Hamza-Anver/OmniStimDriverBoard-PCB/README.md

# OmniStim Eval Board

This is an evaluation board to test operating principles of the OptiStim head unit. 

Fabricated with JLCPCB in April 2025, designed with KiCAD.

It is designed to use the ESP32 Audio PLL to create a signal between approximately 5MHz to 80MHz. This signal is then conditioned and used to drive an LC tank, where the capacitance can be varied digitally and by the DIP switches.

Future designs will have their capacitance entirely digitally controlled, and be miniaturized.

This board is intended only to test if the ESP32 with this conditioning can successfully drive the LC tank and if the resonance of the tank can be subsequently measured by the ESP32. 

# ChangeLog
## Revision 2 DriverBoard
[x] - switched varicaps from LXRW19V330-050 to LXRW0YV600-054, for JLC availability
[x] - have signal reed relays for coarse capacitance switching

## Revision 2 EvalBoard
[x] - USB to Serial RX TX swapped
[x] - Added RXT and TXT LEDs for serial status
[x] - Typo JTAG connector (TDI instead of 3V3)
[x] - Missing EN and IO0 on UART breakout added
[x] - Added USB C connector using ESP32 USB OTG pins (also changed ADC pin on ESP32)
[ ] - added a lot more testpoints

## Revision 1 EvalBoard
[GitHub Commit ID: ace2972b83d641ddb22a6ab950a8797fcb3666a8](https://github.com/Hamza-Anver/OmniStimEvalBoard-Hardware/tree/ace2972b83d641ddb22a6ab950a8797fcb3666a8)
Was revision 1
