Hamza-Anver/OmniStimDriverBoard-PCB/plots/OptoGeneticHeadStage__Assembly.pdf

1 | 2 | 3 | 4 | 5 | 6

A

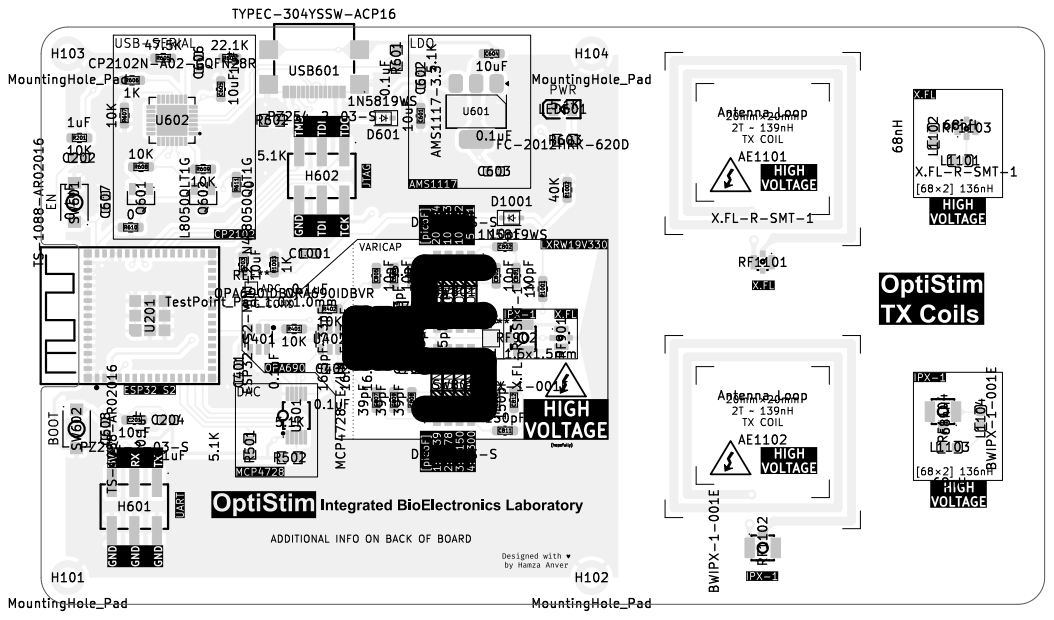
[picture p1: page 1]

ADDITIONAL INFO ON BACK OF BOARD

1 | 2 | 3 | 4 | 5 | 6

A

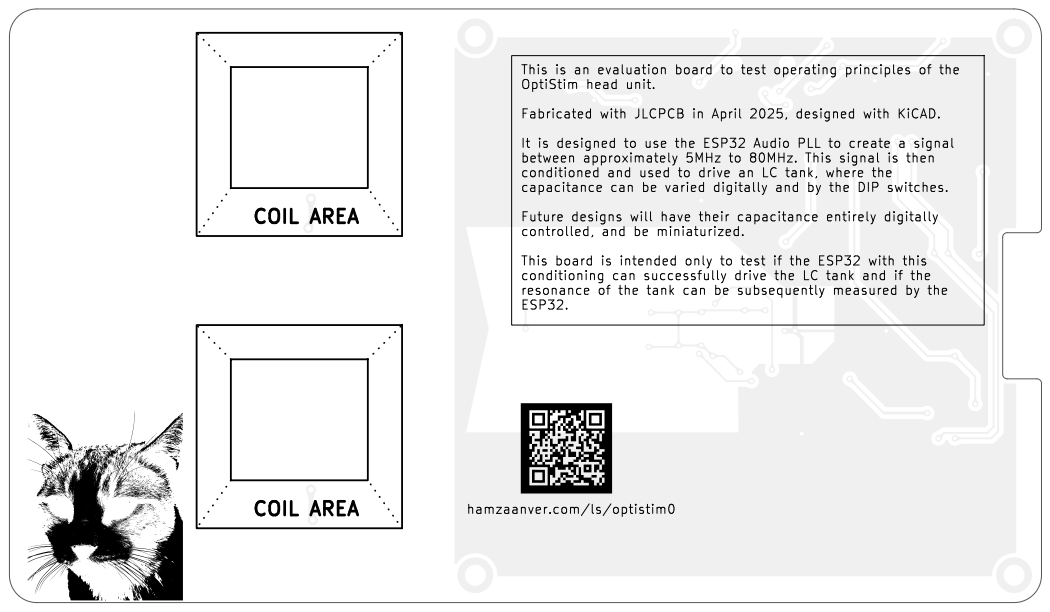
[picture p2: page 2]
COIL; AREA; hamzaanver.com/ls/optistim0 This is an evaluation; board to test operating; principles; of the OptiStim head unit. Fabricated; with JLCPCB in April 2025, designed with KiCAD.; It is designed to use the ESP32 Audio PLL to create; signal between approximately; 5MHz to 80MHz.; This signal is; then; conditioned; and used to drive an LC tank, where the; capacitance; can be varied digitally; and; by the; DIP switches. Future designs will have their capacitance; entirely digitally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
