Hamza-Anver/OmniStimDriverBoard-PCB/OmniStimDriverBoard-PCB.kicad_sch

## KiCad design OmniStimDriverBoard-PCB.kicad_sch (2025-04-27)

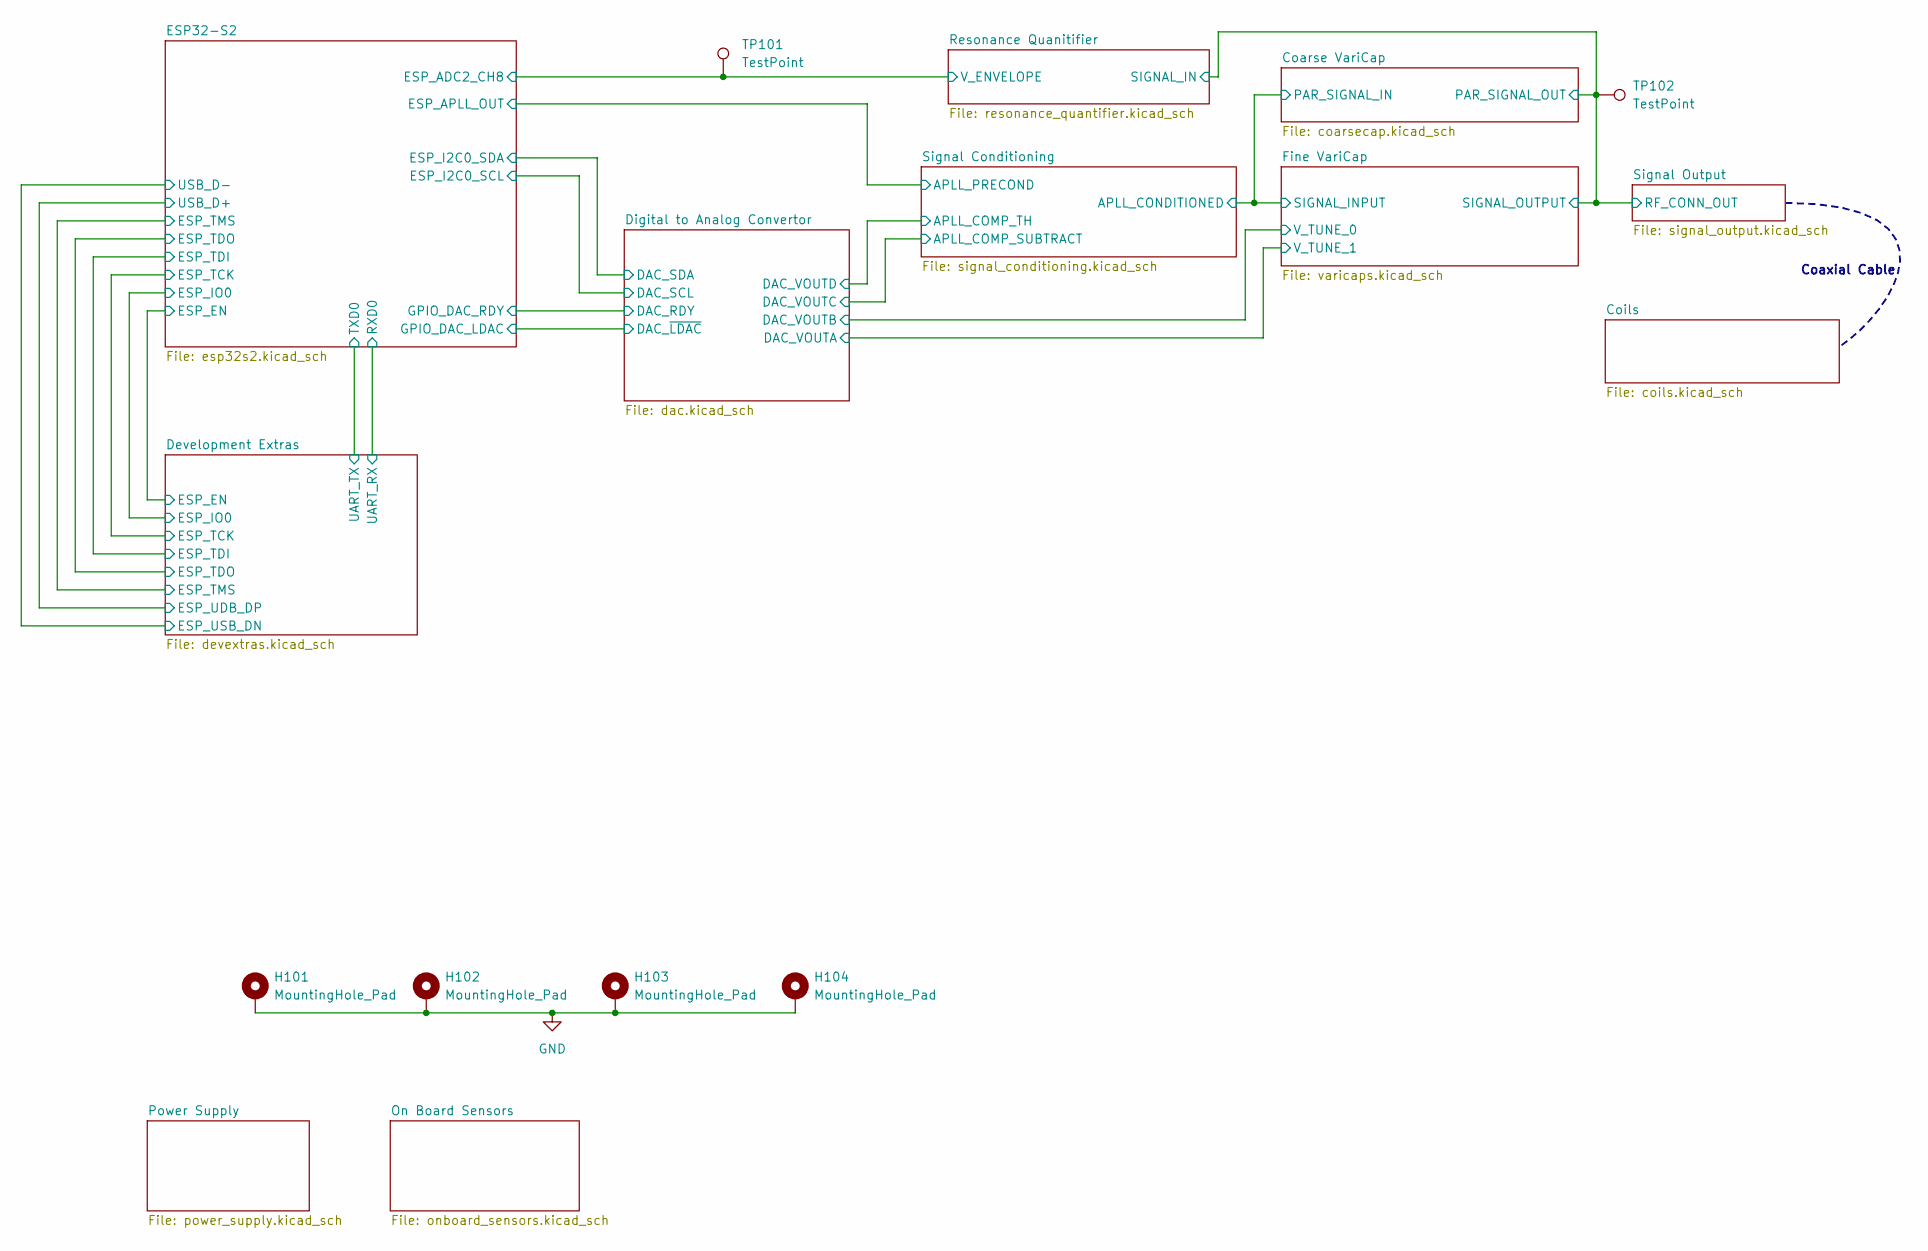
[picture p3: schematic OmniStimDriverBoard-PCB.kicad_sch]

Parts:
H101, H102, H103, H104: MountingHole_Pad; MountingHole_2.2mm_M2_ISO14580_Pad_TopBottom
TP101, TP102: TestPoint; TestPoint_Pad_1.0x1.0mm

Connections:
GND: H101.1, H102.1, H103.1, H104.1
SIGNAL_IN: TP102.1
V_ENVELOPE: TP101.1

Notes on the sheet:
Coaxial Cable
