Hamza-Anver/OmniStimDriverBoard-PCB/coarsecap.kicad_sch

## KiCad design coarsecap.kicad_sch (2025-04-27)

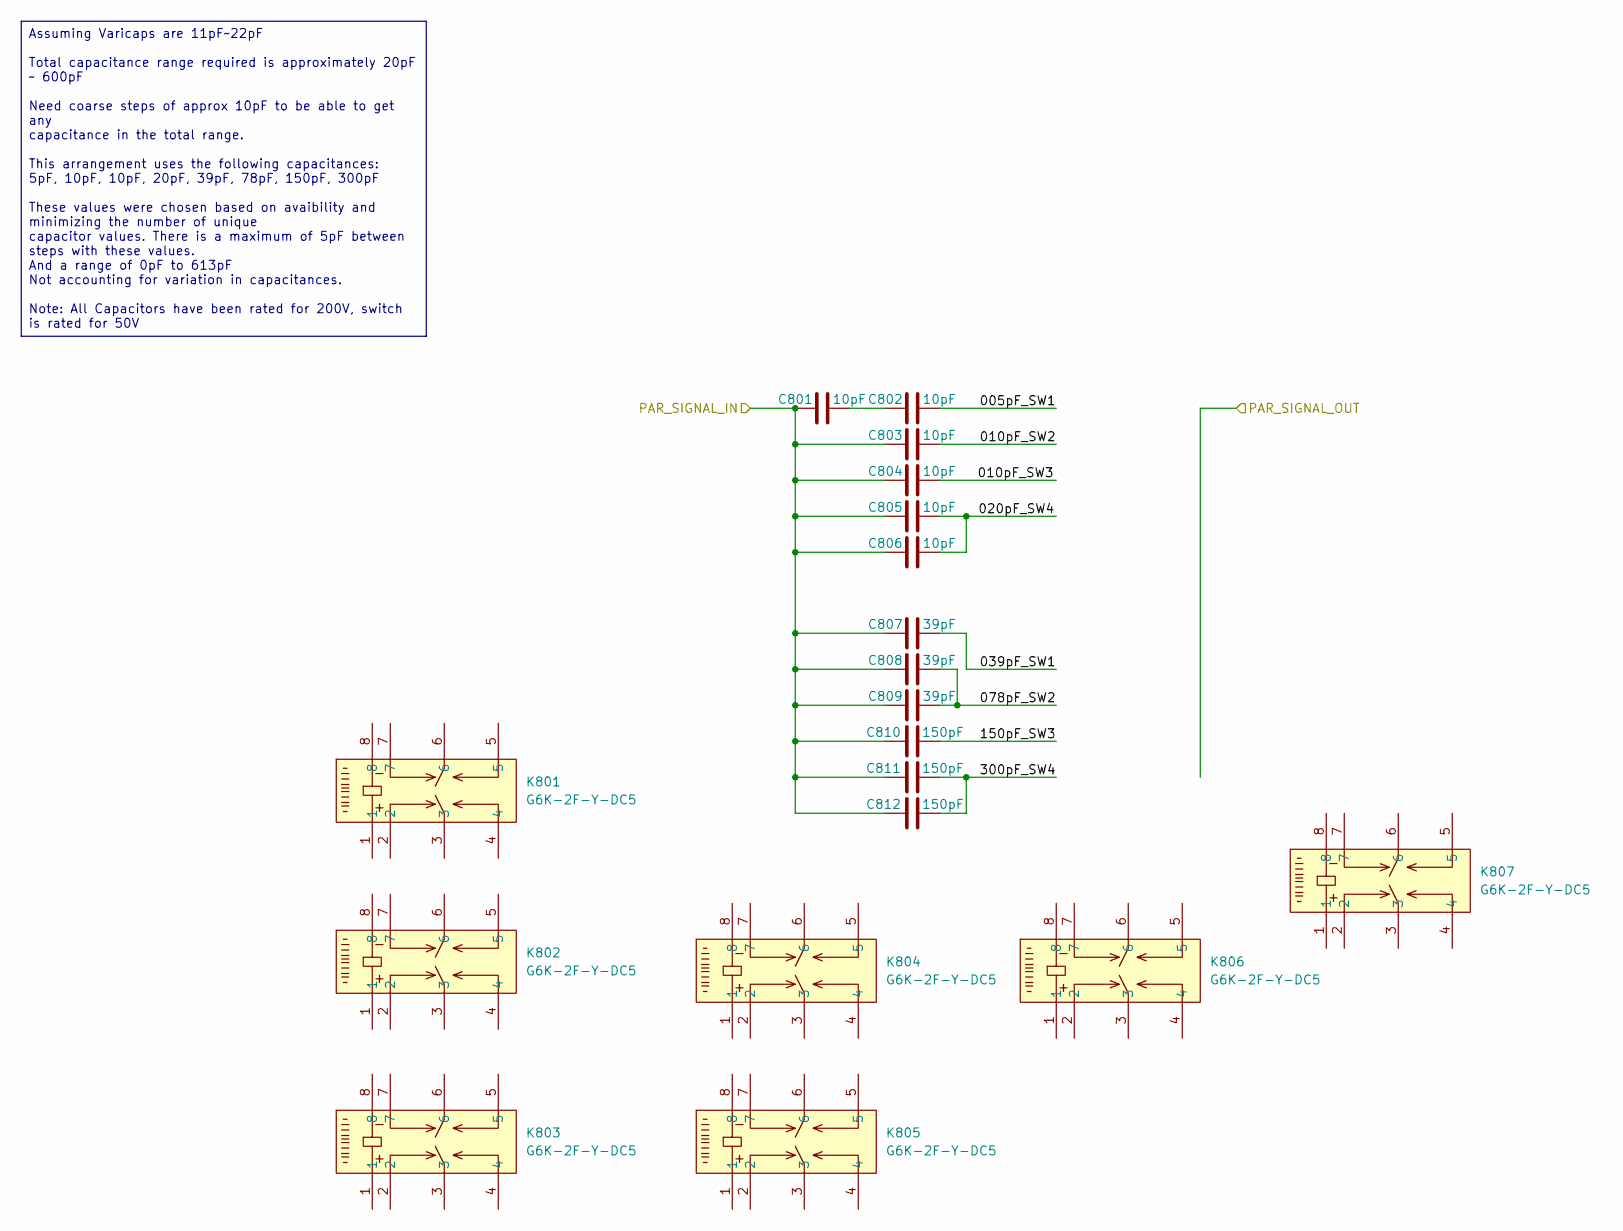
[picture p4: schematic coarsecap.kicad_sch]

Parts:
C801, C802, C803, C804, C805, C806: 10pF; C_0603_1608Metric_Pad1.08x0.95mm_HandSolder; MPN 0603CG100J201NT; LCSC C63673
C807, C808, C809: 39pF; C_0603_1608Metric_Pad1.08x0.95mm_HandSolder; MPN 0603CG390J201NT; LCSC C63687
C810, C811, C812: 150pF; C_0603_1608Metric_Pad1.08x0.95mm_HandSolder; MPN 0603CG151J201NT; LCSC C63701
K801, K802, K803, K804, K805, K806, K807: G6K-2F-Y-DC5; RELAY-SMD_G6K-2F-X-XX; LCSC Part C47190

Connections:
005pF_SW1: C802.2
010pF_SW2: C803.2
010pF_SW3: C804.2
020pF_SW4: C805.2, C806.2
039pF_SW1: C807.2
078pF_SW2: C808.2, C809.2
150pF_SW3: C810.2
300pF_SW4: C811.2, C812.2
unnamed: C801.2, C802.1
PAR_SIGNAL_IN: C801.1, C803.1, C804.1, C805.1, C806.1, C807.1, C808.1, C809.1, C810.1, C811.1, C812.1

Notes on the sheet:
Assuming Varicaps are 11pF~22pF Total capacitance range required is approximately 20pF ~ 600pF Need coarse steps of approx 10pF to be able to get any capacitance in the total range. This arrangement uses the following capacitances: 5pF, 10pF, 10pF, 20pF, 39pF, 78pF, 150pF, 300pF These values were c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
