Hamza-Anver/OmniStimDriverBoard-PCB/coils.kicad_sch

## KiCad design coils.kicad_sch (2025-04-14)

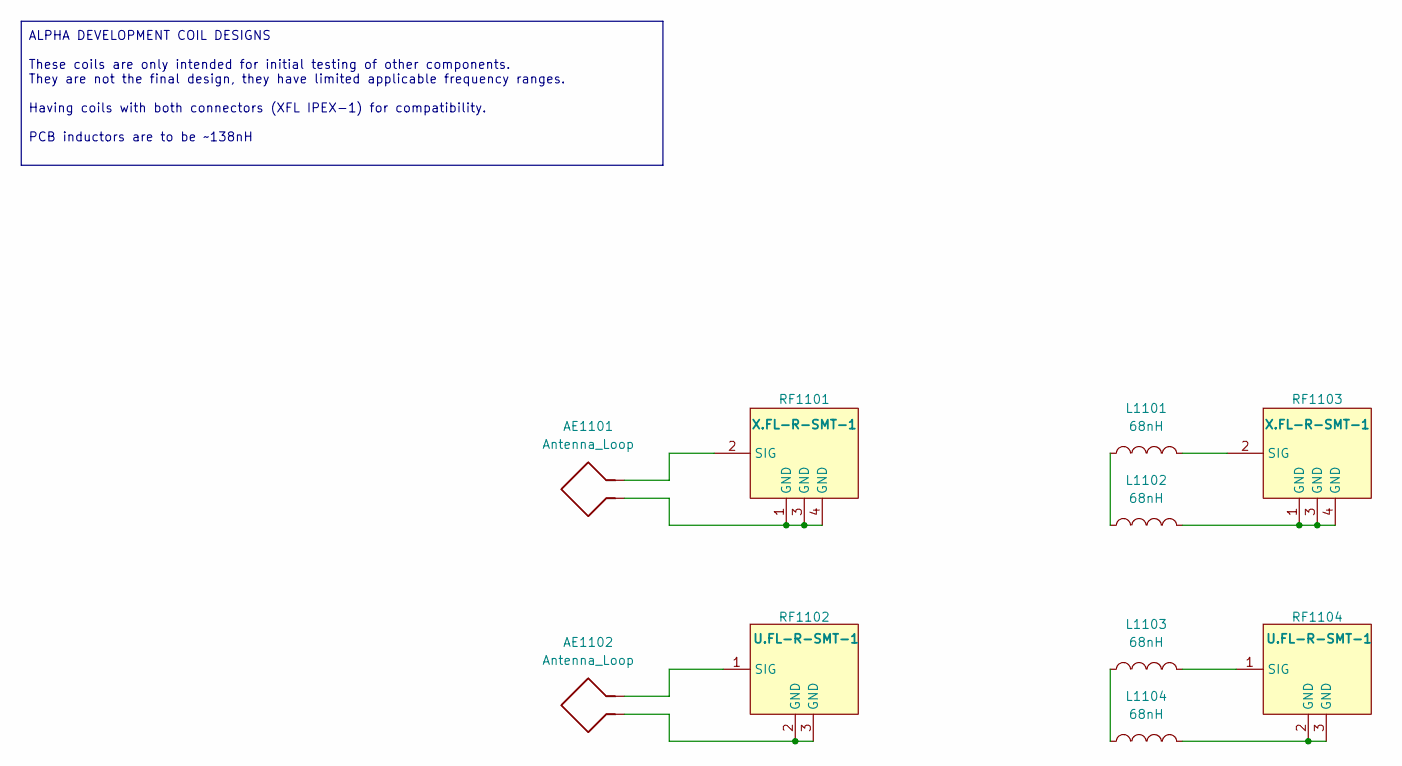
[picture p5: schematic coils.kicad_sch]

Parts:
AE1101, AE1102: Antenna_Loop; Tx_20x20_2t
L1101, L1102, L1103, L1104: 68nH; L0603; MPN LQG18HN68NJ00D; LCSC Part C162555
RF1101, RF1103: X.FL-R-SMT-1; ANT-SMD_XFL-R-SMT-1; MPN X.FL-R-SMT-1(80); LCSC Part C434819
RF1102, RF1104: U.FL-R-SMT-1; RF-SMD_FRF05002-JSS103M; LCSC Part C88374

Connections:
unnamed: AE1101.1, RF1101.1 (GND), RF1101.3 (GND), RF1101.4 (GND)
unnamed: AE1101.2, RF1101.2 (SIG)
unnamed: AE1102.1, RF1102.2 (GND), RF1102.3 (GND)
unnamed: AE1102.2, RF1102.1 (SIG)
unnamed: L1101.1, RF1103.2 (SIG)
unnamed: L1101.2, L1102.2
unnamed: L1102.1, RF1103.1 (GND), RF1103.3 (GND), RF1103.4 (GND)
unnamed: L1103.1, RF1104.1 (SIG)
unnamed: L1103.2, L1104.2
unnamed: L1104.1, RF1104.2 (GND), RF1104.3 (GND)

Notes on the sheet:
ALPHA DEVELOPMENT COIL DESIGNS These coils are only intended for initial testing of other components. They are not the final design, they have limited applicable frequency ranges. Having coils with both connectors (XFL IPEX-1) for compatibility. PCB inductors are to be ~138nH
