Hamza-Anver/OmniStimDriverBoard-PCB/dac.kicad_sch

## KiCad design dac.kicad_sch (2025-04-14)

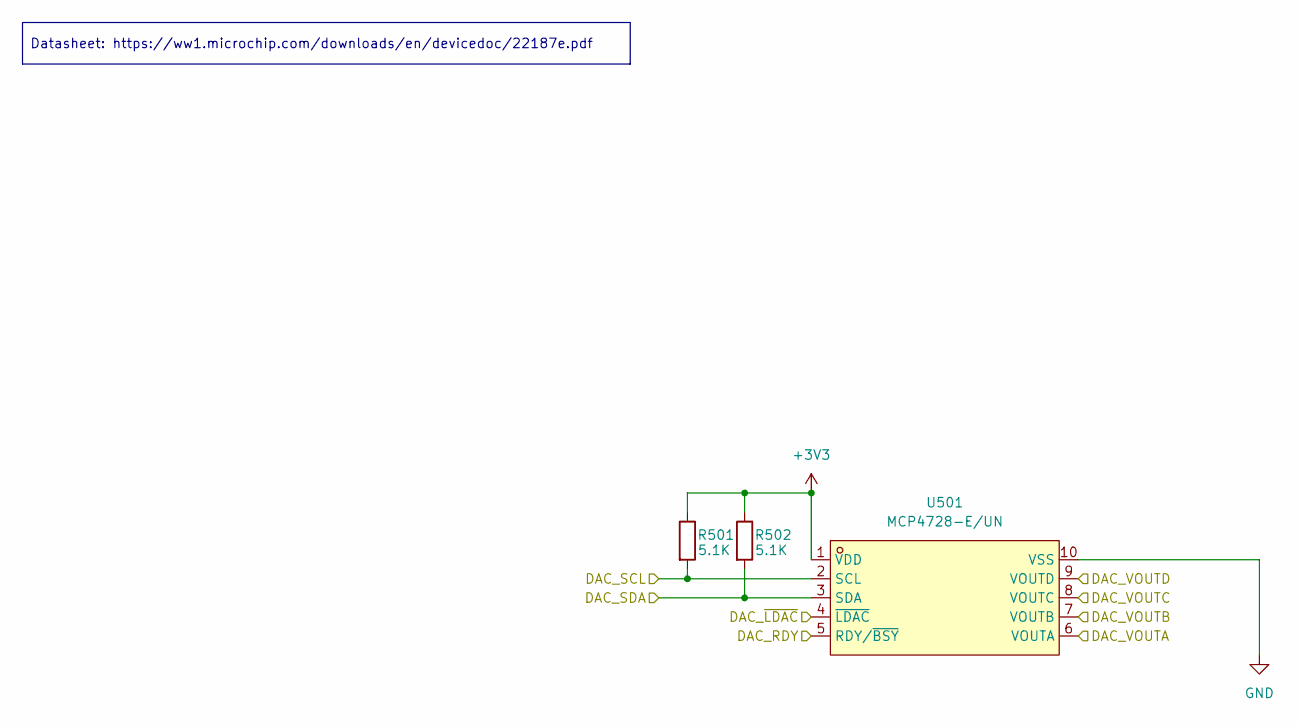
[picture p6: schematic dac.kicad_sch]

Parts:
R501, R502: 5.1K; R0603; MPN RC0603FR-075K1L; LCSC Part C105580
U501: MCP4728-E/UN; MSOP-10_L3.0-W3.0-P0.50-LS5.0-TL; LCSC Part C108207

Connections:
+3V3: R501.2, R502.2, U501.1 (VDD)
DAC_RDY: U501.5 (RDY/~BSY)
DAC_SCL: R501.1, U501.2 (SCL)
DAC_SDA: R502.1, U501.3 (SDA)
DAC_VOUTA: U501.6 (VOUTA)
DAC_VOUTB: U501.7 (VOUTB)
DAC_VOUTC: U501.8 (VOUTC)
DAC_VOUTD: U501.9 (VOUTD)
DAC_~LDAC: U501.4 (~LDAC)
GND: U501.10 (VSS)

Notes on the sheet:
Datasheet: https://ww1.microchip.com/downloads/en/devicedoc/22187e.pdf
