Hamza-Anver/OmniStimDriverBoard-PCB/devextras.kicad_sch

## KiCad design devextras.kicad_sch (2025-04-23)

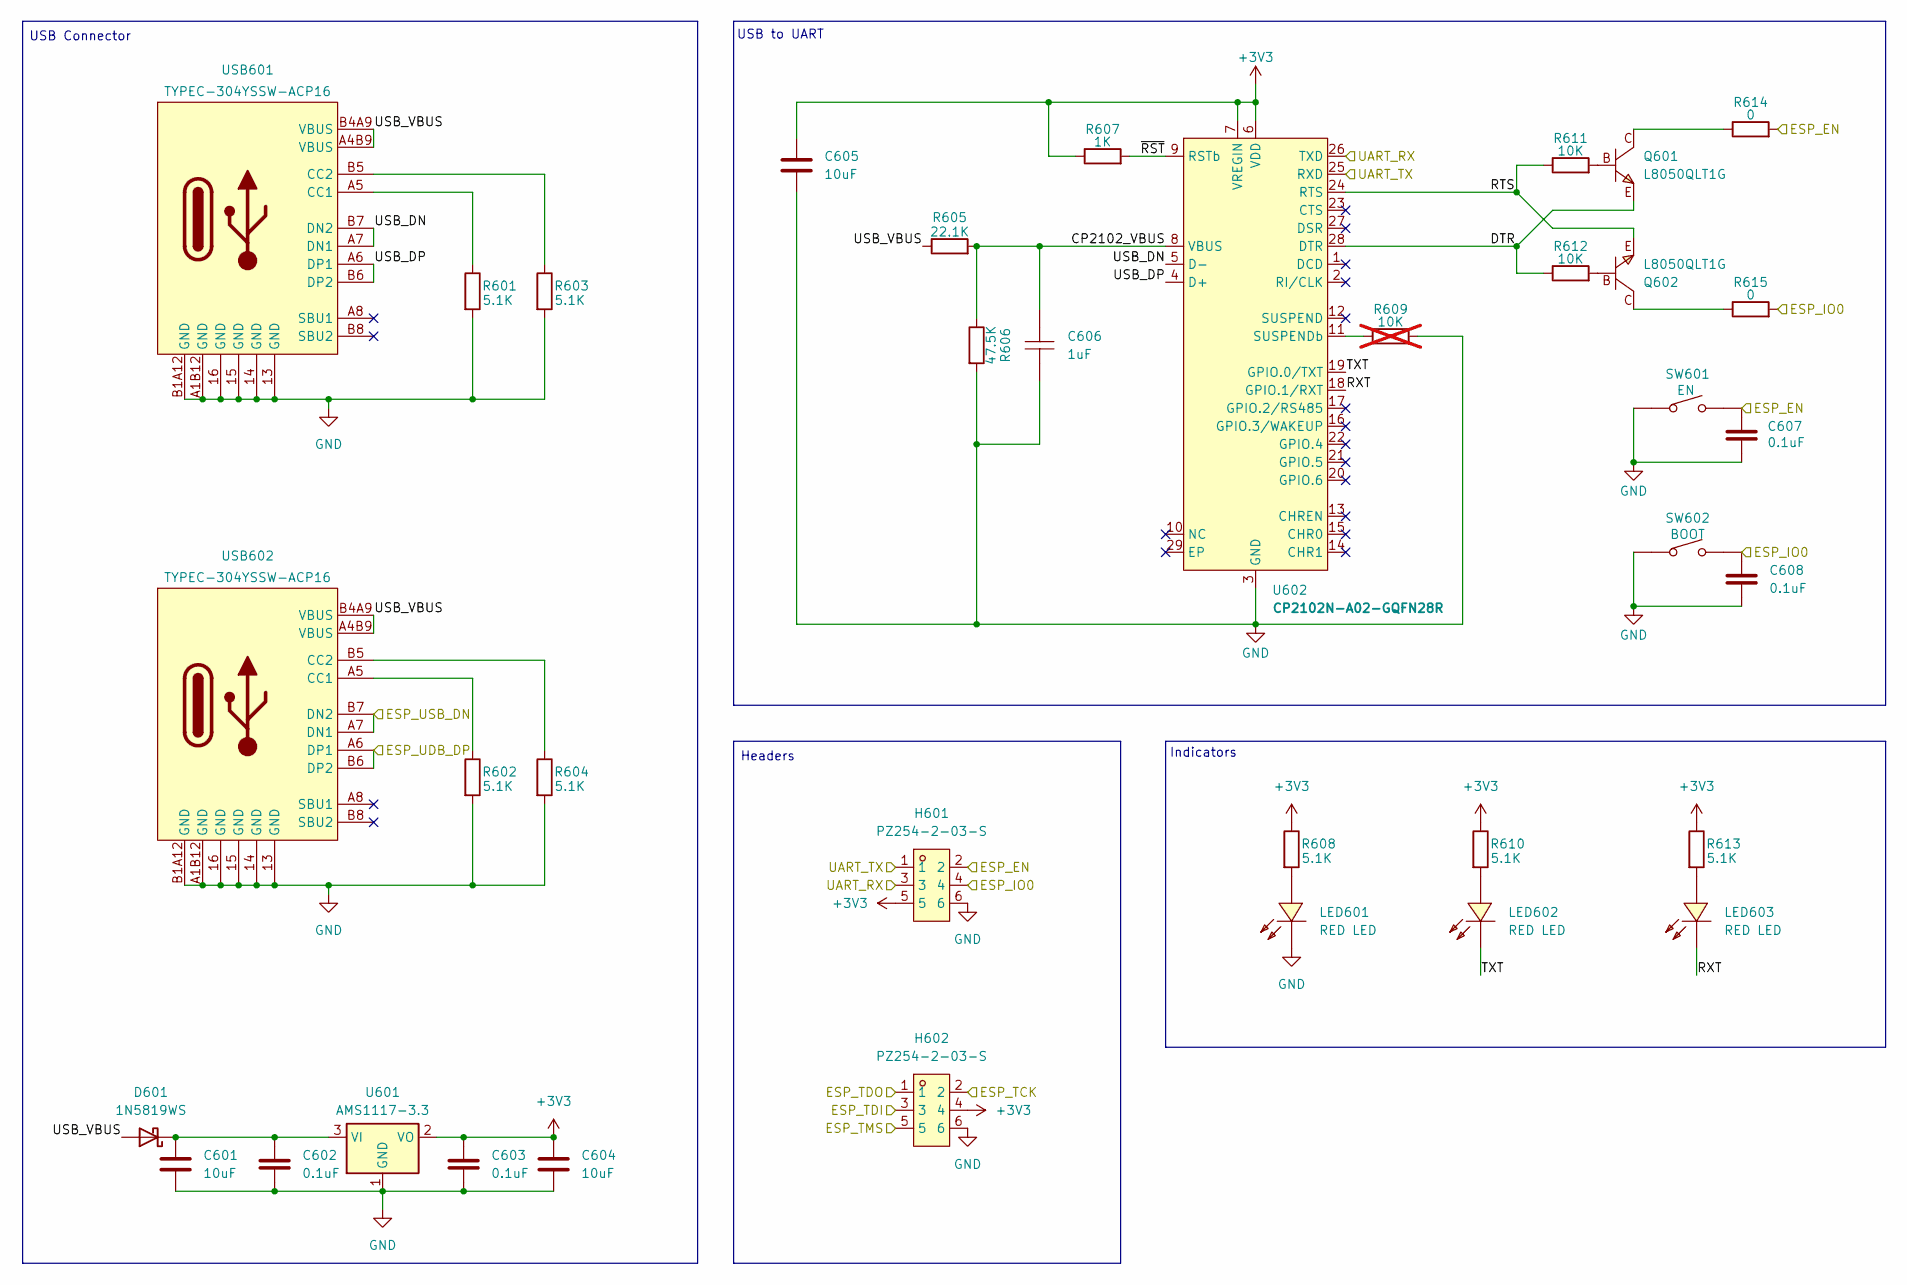
[picture p7: schematic devextras.kicad_sch]

Parts:
C601, C604, C605: 10uF; C_0603_1608Metric_Pad1.08x0.95mm_HandSolder; MPN CL10A106MA8NRNC; LCSC C96446
C602, C603, C607, C608: 0.1uF; C0402; MPN GRM155R71A104KA01J; LCSC Part C6955083
C606: 1uF; C0402; MPN CL05A105KA5NQNC; LCSC Part C52923
D601: 1N5819WS; D_SOD-323
H601, H602: PZ254-2-03-S; HDR-SMD_6P-P2.54-V-M-R2-C3-LS7.5-2; MPN PZ254-2-03-S; LCSC Part C3294461
LED601, LED602, LED603: RED LED; LED0805-R-RD; LCSC Part C84256
Q601, Q602: L8050QLT1G; SOT-23-3_L2.9-W1.3-P1.90-LS2.4-BR; LCSC Part C49581
R601, R602, R603, R604, R608, R610, R613: 5.1K; R0603; MPN RC0603FR-075K1L; LCSC Part C105580
R605: 22.1K; R_0603_1608Metric; MPN RC0603FR-0722K1L; LCSC C137768
R606: 47.5K; R_0603_1608Metric_Pad0.98x0.95mm_HandSolder; MPN FRC0603F4752TS; LCSC C2933225
R607: 1K; R_0603_1608Metric_Pad0.98x0.95mm_HandSolder; MPN RC0603FR-071KL; LCSC C22548
R609: 10K; R_0603_1608Metric_Pad0.98x0.95mm_HandSolder; not fitted
R611, R612: 10K; R_0603_1608Metric_Pad0.98x0.95mm_HandSolder; MPN 0603WAF1002T5E; LCSC C25804
R614, R615: 0; R_0603_1608Metric_Pad0.98x0.95mm_HandSolder; MPN FRC0603P000 TS; LCSC C2907080
SW601, SW602: TS-1088-AR02016; SW-SMD_L3.9-W3.0-P4.45; MPN TS-1088-AR02016; LCSC Part C720477
U601: AMS1117-3.3; SOT-223-3_TabPin2
U602: CP2102N-A02-GQFN28R; QFN-28_L5.0-W5.0-P0.50-TL-EP3.3; LCSC Part C964632
USB601, USB602: TYPEC-304YSSW-ACP16; USB-SMD_TYPEC-304YSSW-ACP16; LCSC Part C2840392

Connections:
+3V3: C603.2, C604.1, C605.1, H601.5, H602.4, R607.1, R608.2, R610.2, R613.2, U601.2 (VO), U602.6 (VDD), U602.7 (VREGIN)
CP2102_VBUS: C606.2, R605.2, R606.1, U602.8 (VBUS)
DTR: Q601.2 (E), R612.1, U602.28 (DTR)
ESP_EN: C607.2, H601.2, R614.2, SW601.2
ESP_IO0: C608.2, H601.4, R615.2, SW602.2
ESP_TCK: H602.2
ESP_TDI: H602.3
ESP_TDO: H602.1
ESP_TMS: H602.5
ESP_UDB_DP: USB602.A6 (DP1), USB602.B6 (DP2)
ESP_USB_DN: USB602.A7 (DN1), USB602.B7 (DN2)
GND: C601.2, C602.1, C603.1, C604.2, C605.2, C606.1, C607.1, C608.1, H601.6, H602.6, LED601.2 (-), R601.1, R602.1, R603.1, R604.1, R606.2, R609.2, SW601.1, SW602.1, U601.1 (GND), U602.3 (GND), USB601.13 (GND), USB601.14 (GND), USB601.15 (GND), USB601.16 (GND), USB601.A1B12 (GND), USB601.B1A12 (GND), USB602.13 (GND), USB602.14 (GND), USB602.15 (GND), USB602.16 (GND), USB602.A1B12 (GND), USB602.B1A12 (GND)
unnamed: C601.1, C602.2, D601.1 (K), U601.3 (VI)
unnamed: LED601.1 (+), R608.1
unnamed: LED602.1 (+), R610.1
unnamed: LED603.1 (+), R613.1
unnamed: Q601.1 (B), R611.2
unnamed: Q601.3 (C), R614.1
unnamed: Q602.1 (B), R612.2
unnamed: Q602.3 (C), R615.1
unnamed: R601.2, USB601.A5 (CC1)
unnamed: R602.2, USB602.A5 (CC1)
unnamed: R603.2, USB601.B5 (CC2)
unnamed: R604.2, USB602.B5 (CC2)
unnamed: R609.1, U602.11 (SUSPENDb)
RTS: Q602.2 (E), R611.1, U602.24 (RTS)
RXT: LED603.2 (-), U602.18 (GPIO.1/RXT)
TXT: LED602.2 (-), U602.19 (GPIO.0/TXT)
UART_RX: H601.3, U602.26 (TXD)
UART_TX: H601.1, U602.25 (RXD)
USB_DN: U602.5 (D-), USB601.A7 (DN1), USB601.B7 (DN2)
USB_DP: U602.4 (D+), USB601.A6 (DP1), USB601.B6 (DP2)
USB_VBUS: D601.2 (A), R605.1, USB601.A4B9 (VBUS), USB601.B4A9 (VBUS), USB602.A4B9 (VBUS), USB602.B4A9 (VBUS)
~RST: R607.2, U602.9 (RSTb)

Notes on the sheet:
Headers
USB to UART
USB Connector
Indicators
