Hamza-Anver/OmniStimDriverBoard-PCB/esp32s2.kicad_sch

## KiCad design esp32s2.kicad_sch (2025-04-23)

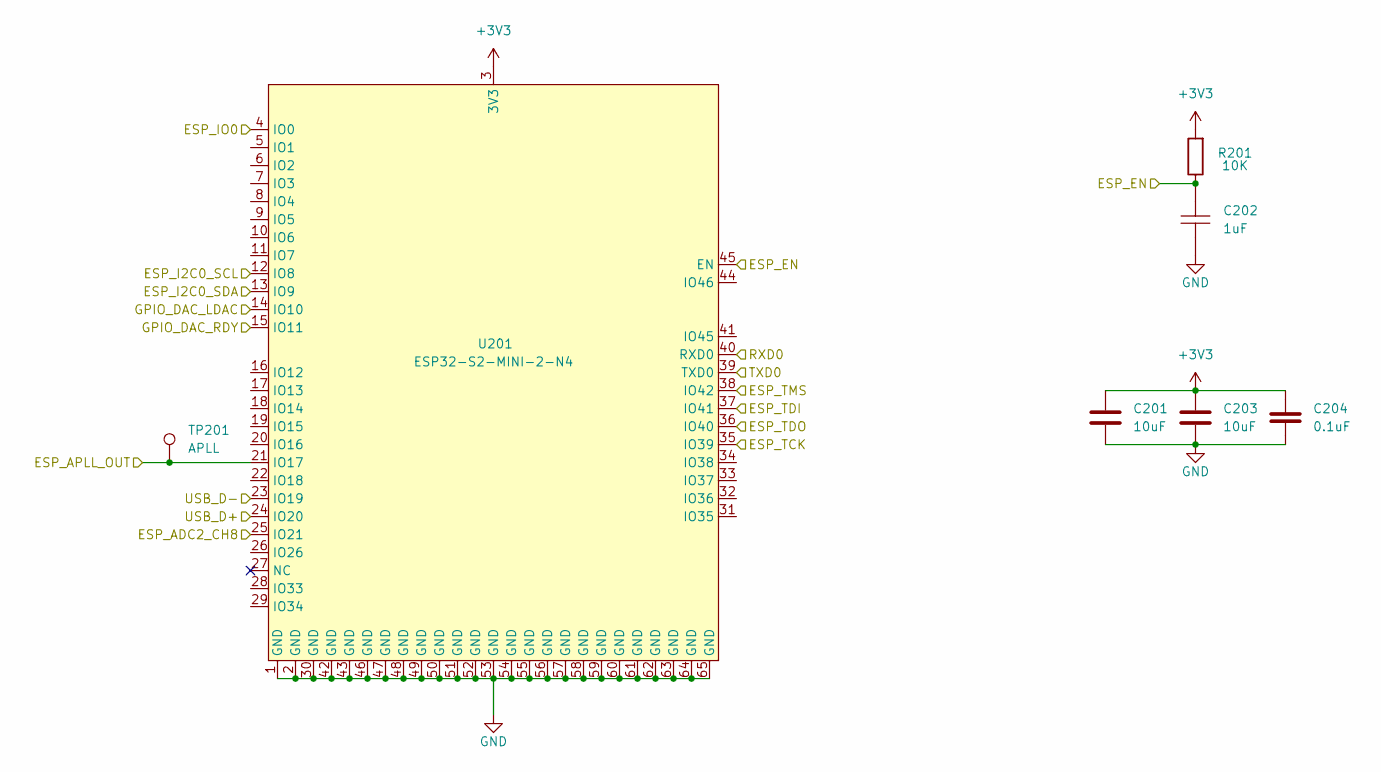
[picture p8: schematic esp32s2.kicad_sch]

Parts:
C201, C203: 10uF; C_0603_1608Metric_Pad1.08x0.95mm_HandSolder; MPN CL10A106MA8NRNC; LCSC C96446
C202: 1uF; C0402; MPN CL05A105KA5NQNC; LCSC Part C52923
C204: 0.1uF; C0402; MPN GRM155R71A104KA01J; LCSC Part C6955083
R201: 10K; R_0603_1608Metric_Pad0.98x0.95mm_HandSolder; MPN 0603WAF1002T5E; LCSC C25804
TP201: APLL; TestPoint_Pad_1.0x1.0mm
U201: ESP32-S2-MINI-2-N4; WIFI-SMD_ESP32-MINI-1-N4; LCSC Part C3013906

Connections:
+3V3: C201.1, C203.1, C204.2, R201.2, U201.3 (3V3)
ESP_ADC2_CH8: U201.25 (IO21)
ESP_APLL_OUT: TP201.1, U201.21 (IO17)
ESP_EN: C202.2, R201.1, U201.45 (EN)
ESP_I2C0_SCL: U201.12 (IO8)
ESP_I2C0_SDA: U201.13 (IO9)
ESP_IO0: U201.4 (IO0)
ESP_TCK: U201.35 (IO39)
ESP_TDI: U201.37 (IO41)
ESP_TDO: U201.36 (IO40)
ESP_TMS: U201.38 (IO42)
GND: C201.2, C202.1, C203.2, C204.1, U201.1 (GND), U201.2 (GND), U201.30 (GND), U201.42 (GND), U201.43 (GND), U201.46 (GND), U201.47 (GND), U201.48 (GND), U201.49 (GND), U201.50 (GND), U201.51 (GND), U201.52 (GND), U201.53 (GND), U201.54 (GND), U201.55 (GND), U201.56 (GND), U201.57 (GND), U201.58 (GND), U201.59 (GND), U201.60 (GND), U201.61 (GND), U201.62 (GND), U201.63 (GND), U201.64 (GND), U201.65 (GND)
GPIO_DAC_LDAC: U201.14 (IO10)
GPIO_DAC_RDY: U201.15 (IO11)
RXD0: U201.40 (RXD0)
TXD0: U201.39 (TXD0)
USB_D+: U201.24 (IO20)
USB_D-: U201.23 (IO19)
