Hamza-Anver/OmniStimDriverBoard-PCB/power_supply.kicad_sch

## KiCad design power_supply.kicad_sch (2025-04-14)

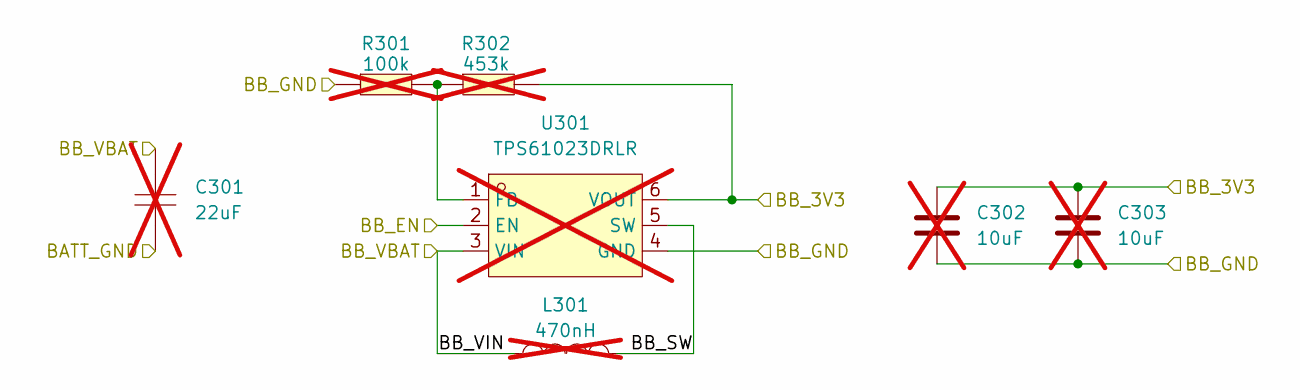
[picture p9: schematic power_supply.kicad_sch]

Parts:
C301: 22uF; C0805; LCSC Part C5674; not fitted
C302, C303: 10uF; C_0603_1608Metric_Pad1.08x0.95mm_HandSolder; MPN CL10A106MA8NRNC; LCSC C96446; not fitted
L301: 470nH; IND-SMD_L2.0-W1.6; LCSC Part C2045043; not fitted
R301: 100k; R0603; LCSC Part C14675; not fitted
R302: 453k; R0603; LCSC Part C25818; not fitted
U301: TPS61023DRLR; SOT-563_L1.6-W1.2-P0.50-LS1.6-BR; LCSC Part C919459; not fitted

Connections:
BATT_GND: C301.2
BB_3V3: C302.1, C303.1, R302.2, U301.6 (VOUT)
BB_EN: U301.2 (EN)
BB_GND: C302.2, C303.2, R301.1, U301.4 (GND)
BB_SW: L301.1, U301.5 (SW)
BB_VBAT: C301.1, L301.2, U301.3 (VIN)
unnamed: R301.2, R302.1, U301.1 (FB)
