Hamza-Anver/OmniStimDriverBoard-PCB/resonance_quantifier.kicad_sch

## KiCad design resonance_quantifier.kicad_sch (2025-04-14)

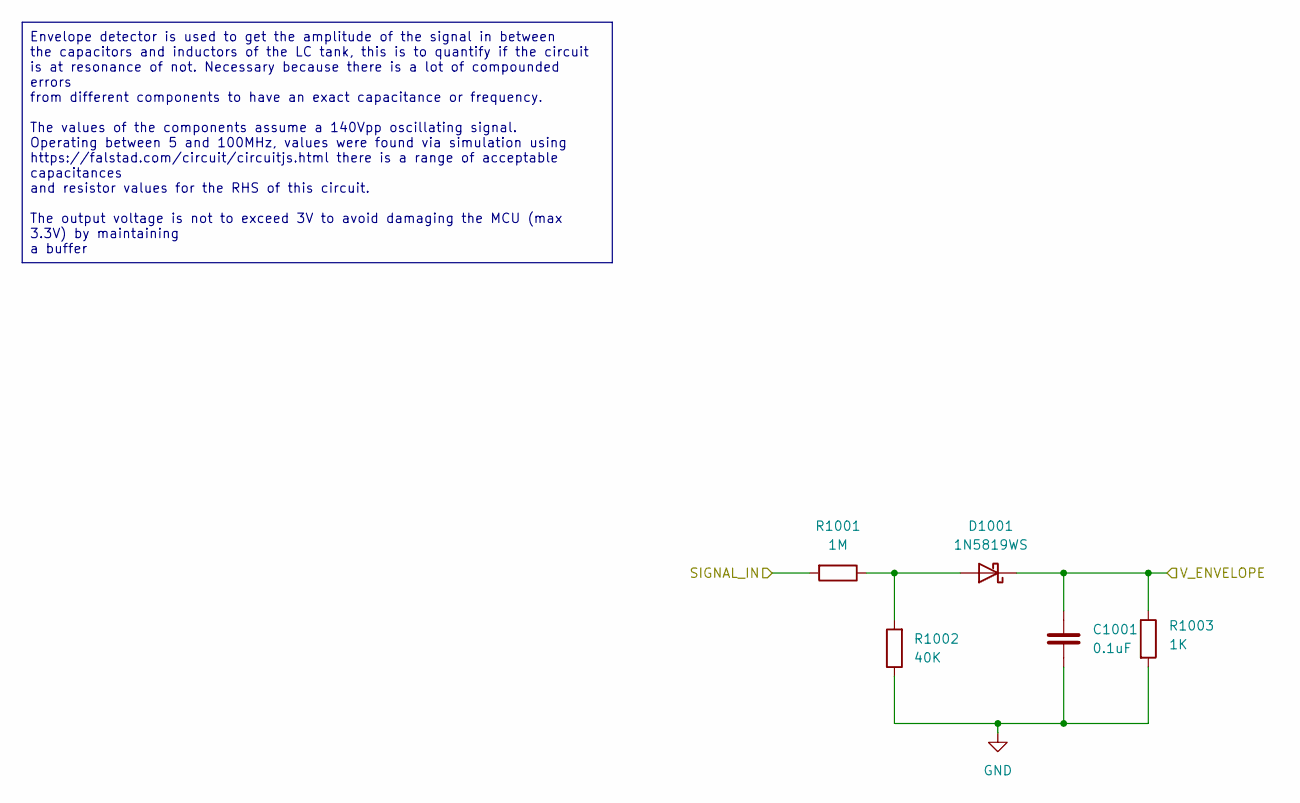
[picture p10: schematic resonance_quantifier.kicad_sch]

Parts:
C1001: 0.1uF; C0402; MPN GRM155R71A104KA01J; LCSC Part C6955083
D1001: 1N5819WS; D_SOD-323
R1001: 1M; R_0603_1608Metric_Pad0.98x0.95mm_HandSolder; MPN RC0603FR-071ML; LCSC C105578
R1002: 40K; R_0603_1608Metric_Pad0.98x0.95mm_HandSolder; MPN RT0603BRD0740KL; LCSC C861392
R1003: 1K; R_0603_1608Metric_Pad0.98x0.95mm_HandSolder; MPN RC0603FR-071KL; LCSC C22548

Connections:
GND: C1001.1, R1002.1, R1003.2
unnamed: D1001.2 (A), R1001.1, R1002.2
SIGNAL_IN: R1001.2
V_ENVELOPE: C1001.2, D1001.1 (K), R1003.1

Notes on the sheet:
Envelope detector is used to get the amplitude of the signal in between the capacitors and inductors of the LC tank, this is to quantify if the circuit is at resonance of not. Necessary because there is a lot of compounded errors from different components to have an exact capacitance or frequency. 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
