Hamza-Anver/OmniStimDriverBoard-PCB/signal_conditioning.kicad_sch

## KiCad design signal_conditioning.kicad_sch (2025-04-14)

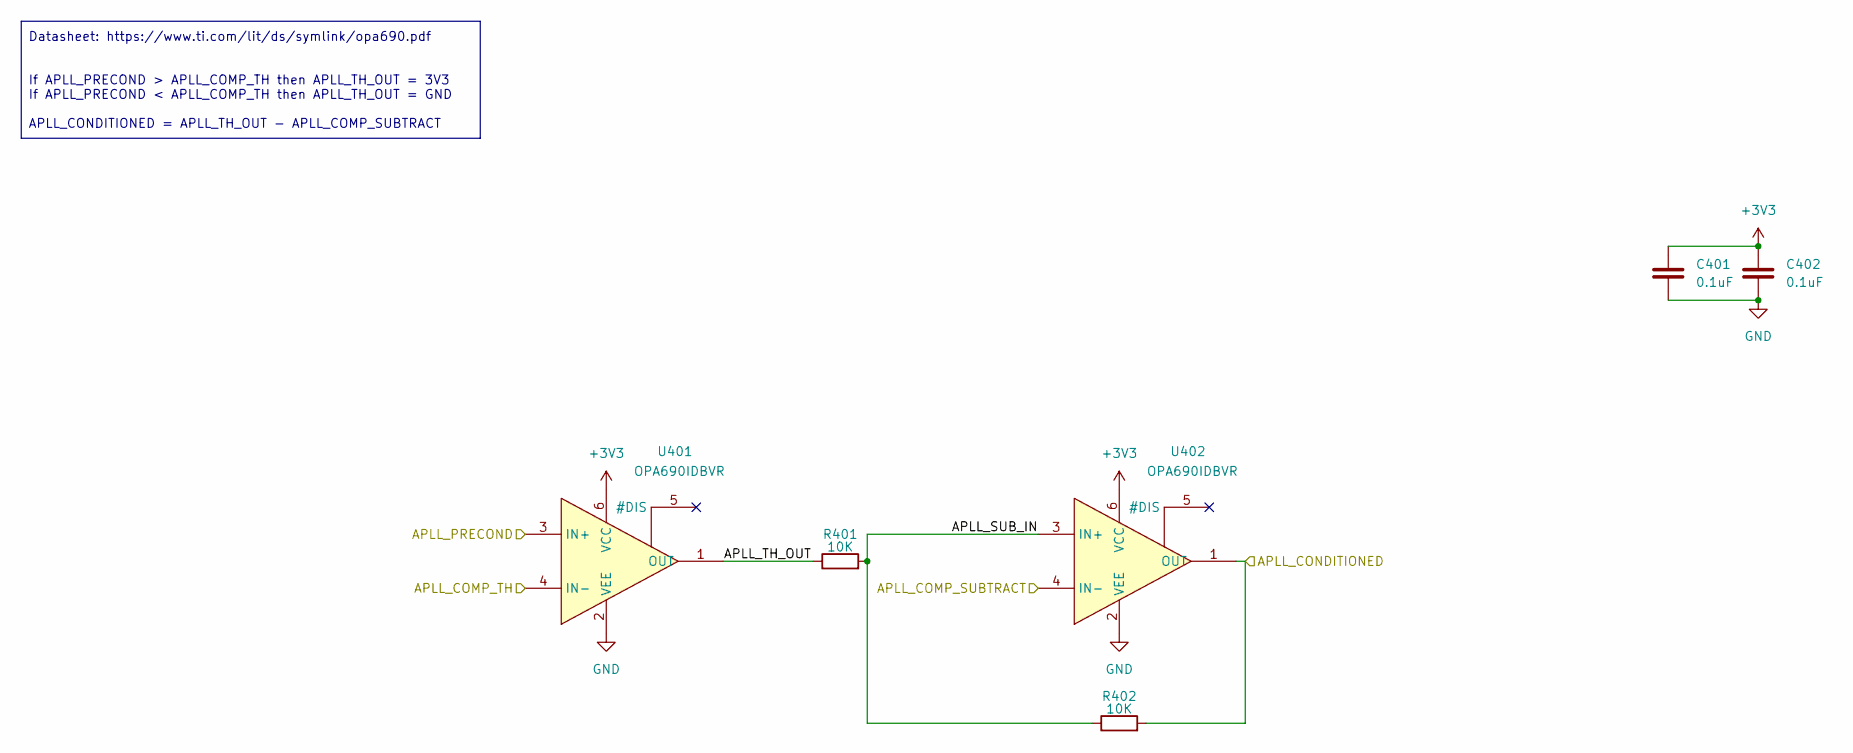
[picture p11: schematic signal_conditioning.kicad_sch]

Parts:
C401, C402: 0.1uF; C0402; MPN GRM155R71A104KA01J; LCSC Part C6955083
R401, R402: 10K; R_0603_1608Metric_Pad0.98x0.95mm_HandSolder; MPN 0603WAF1002T5E; LCSC C25804
U401, U402: OPA690IDBVR; SOT-23-6_L2.9-W1.6-P0.95-LS2.8-BL; LCSC Part C524799

Connections:
+3V3: C401.2, C402.2, U401.6 (VCC), U402.6 (VCC)
APLL_COMP_SUBTRACT: U402.4 (IN-)
APLL_COMP_TH: U401.4 (IN-)
APLL_CONDITIONED: R402.2, U402.1 (OUT)
APLL_PRECOND: U401.3 (IN+)
APLL_SUB_IN: R401.2, R402.1, U402.3 (IN+)
APLL_TH_OUT: R401.1, U401.1 (OUT)
GND: C401.1, C402.1, U401.2 (VEE), U402.2 (VEE)

Notes on the sheet:
Datasheet: https://www.ti.com/lit/ds/symlink/opa690.pdf If APLL_PRECOND > APLL_COMP_TH then APLL_TH_OUT = 3V3 If APLL_PRECOND < APLL_COMP_TH then APLL_TH_OUT = GND APLL_CONDITIONED = APLL_TH_OUT - APLL_COMP_SUBTRACT
