Hamza-Anver/OmniStimDriverBoard-PCB/signal_output.kicad_sch

## KiCad design signal_output.kicad_sch (2025-04-14)

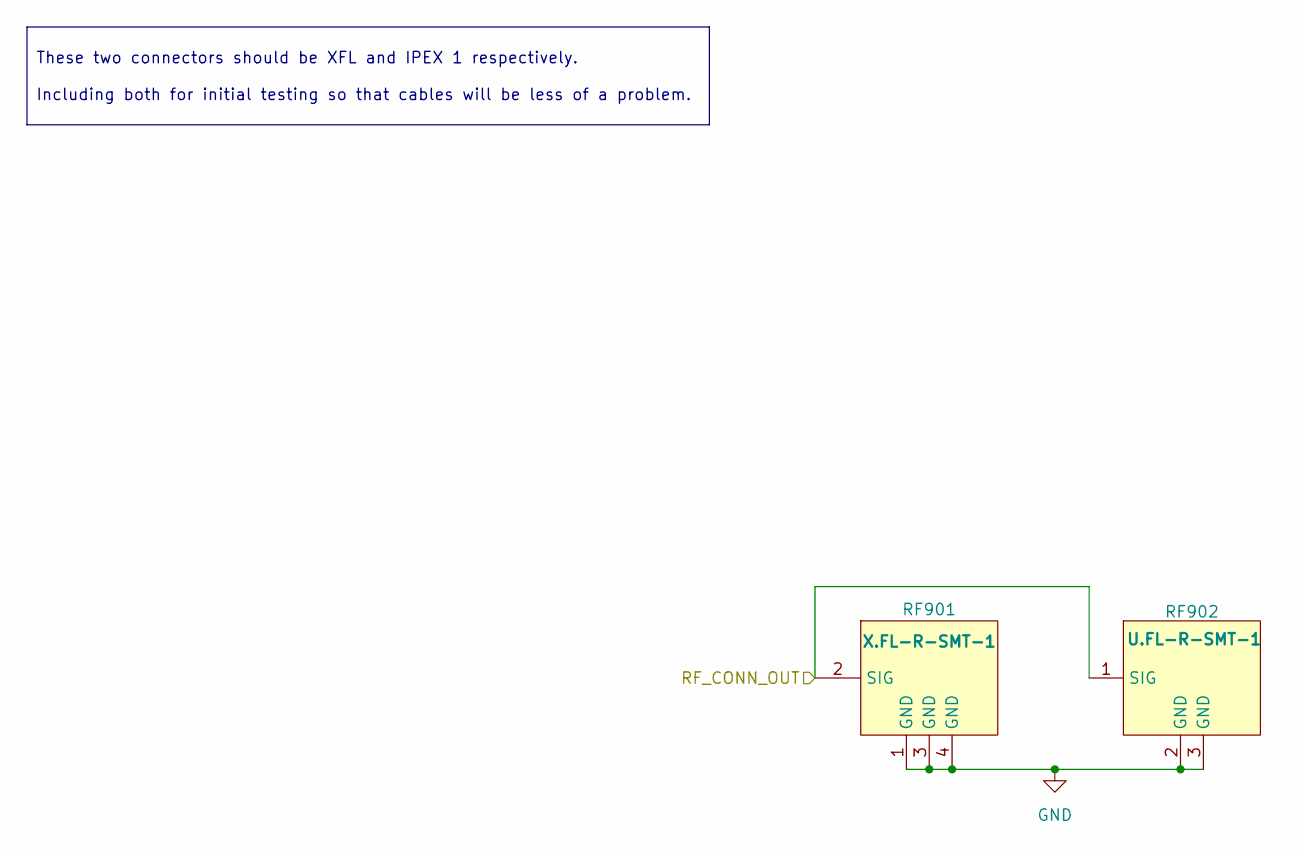
[picture p12: schematic signal_output.kicad_sch]

Parts:
RF901: X.FL-R-SMT-1; ANT-SMD_XFL-R-SMT-1; MPN X.FL-R-SMT-1(80); LCSC Part C434819
RF902: U.FL-R-SMT-1; RF-SMD_FRF05002-JSS103M; LCSC Part C88374

Connections:
GND: RF901.1 (GND), RF901.3 (GND), RF901.4 (GND), RF902.2 (GND), RF902.3 (GND)
RF_CONN_OUT: RF901.2 (SIG), RF902.1 (SIG)

Notes on the sheet:
These two connectors should be XFL and IPEX 1 respectively. Including both for initial testing so that cables will be less of a problem.
