Hamza-Anver/OmniStimDriverBoard-PCB/varicaps.kicad_sch

## KiCad design varicaps.kicad_sch (2025-04-27)

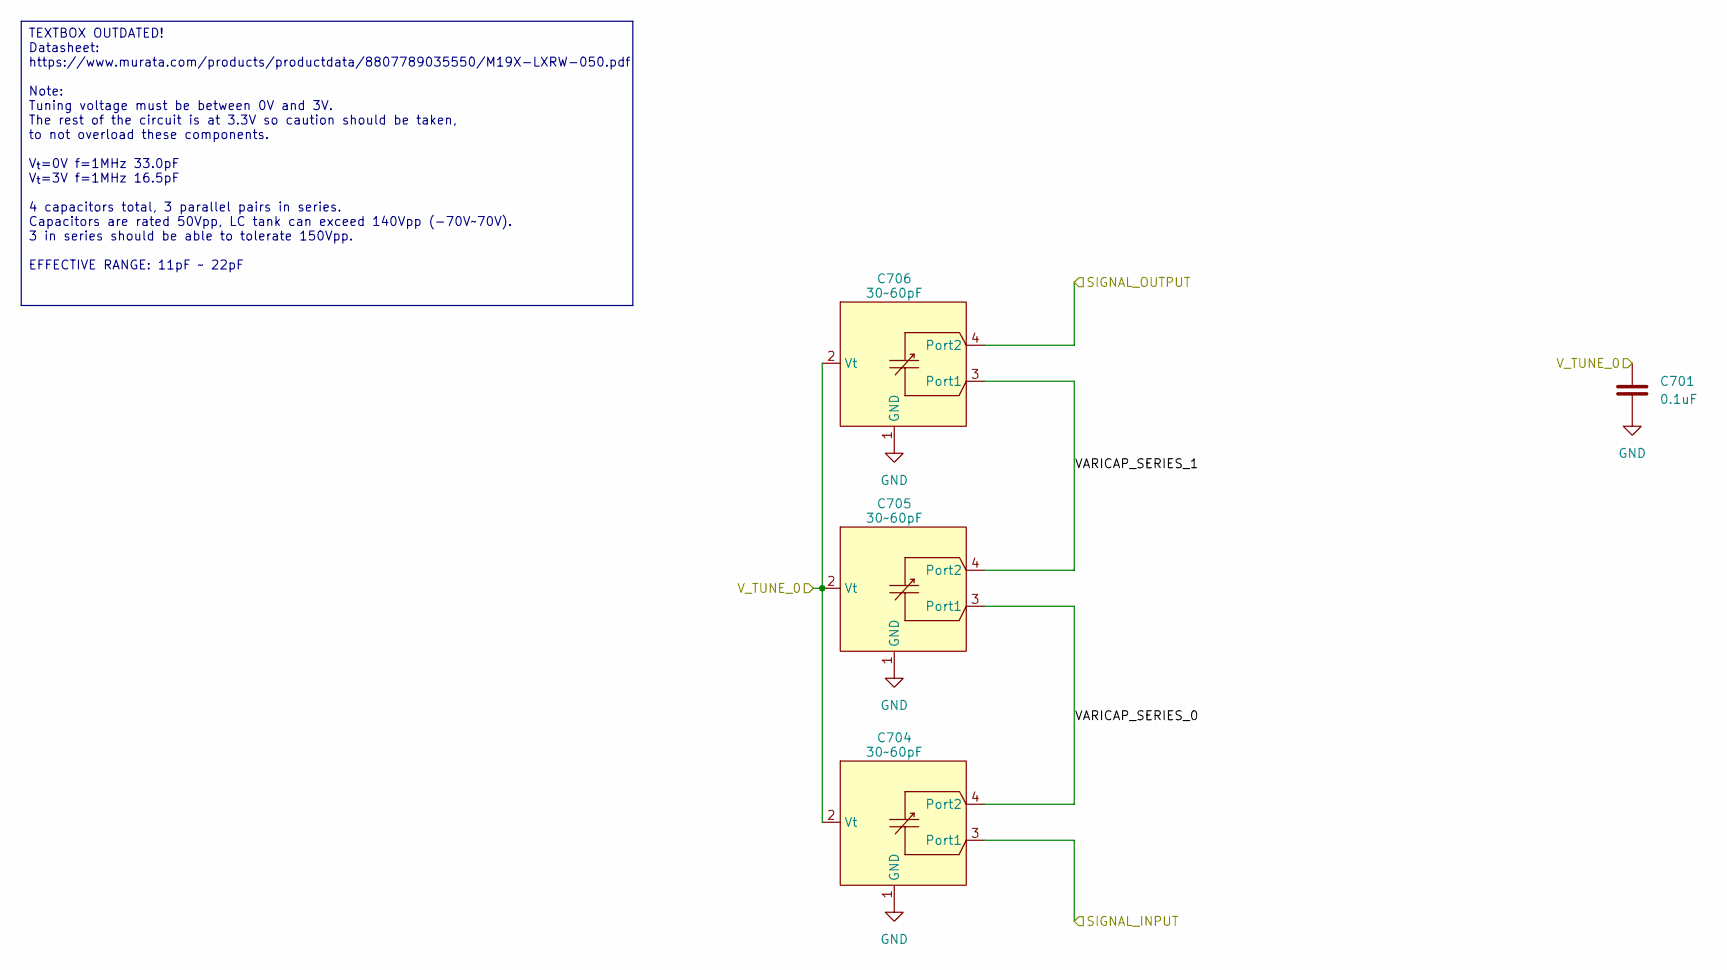
[picture p13: schematic varicaps.kicad_sch]

Parts:
C701: 0.1uF; C0402; MPN GRM155R71A104KA01J; LCSC Part C6955083
C704, C705, C706: 30~60pF; X2SON-4_L0.6-W0.6-P0.40-BL; MPN LXRW0YV600-054; LCSC Part C2988749

Connections:
GND: C701.1, C704.1 (GND), C705.1 (GND), C706.1 (GND)
SIGNAL_INPUT: C704.3 (Port1)
SIGNAL_OUTPUT: C706.4 (Port2)
VARICAP_SERIES_0: C704.4 (Port2), C705.3 (Port1)
VARICAP_SERIES_1: C705.4 (Port2), C706.3 (Port1)
V_TUNE_0: C701.2, C704.2 (Vt), C705.2 (Vt), C706.2 (Vt)

Notes on the sheet:
TEXTBOX OUTDATED! Datasheet: https://www.murata.com/products/productdata/8807789035550/M19X-LXRW-050.pdf Note: Tuning voltage must be between 0V and 3V. The rest of the circuit is at 3.3V so caution should be taken, to not overload these components. V_{t}=0V f=1MHz 33.0pF V_{t}=3V f=1MHz 16.5pF 4 c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
