Hamza-Anver/OmniStimDriverBoard-PCB/(commit log)

2025-04-14 Updated name to omnistim on PCB and README
2025-04-14 updated gitignore synced PCB to schematic
2025-04-23 rev 2 errata resolved
    [OmniStimEvalBoard.kicad_sch, devextras.kicad_sch]
2025-04-23 Additional Rev 2 changes done
    [OmniStimEvalBoard.kicad_sch, devextras.kicad_sch, esp32s2.kicad_sch]
2025-04-27 Renamed project initial commit to new repo
    [OmniStimDriverBoard-PCB.kicad_sch]
2025-04-27 Starting work on OmniStimDriverBoard design
    [OmniStimDriverBoard-PCB.kicad_sch, coarsecap.kicad_sch, varicaps.kicad_sch]
